lindblandro/poly/documentation/img/block-diagram-map.pdf

Loops

Initialization

Arduino

Sequencer

Handler

Acquisition

Concentration

Temperature
