lindblandro/poly/documentation/img/pipelining2.pdf

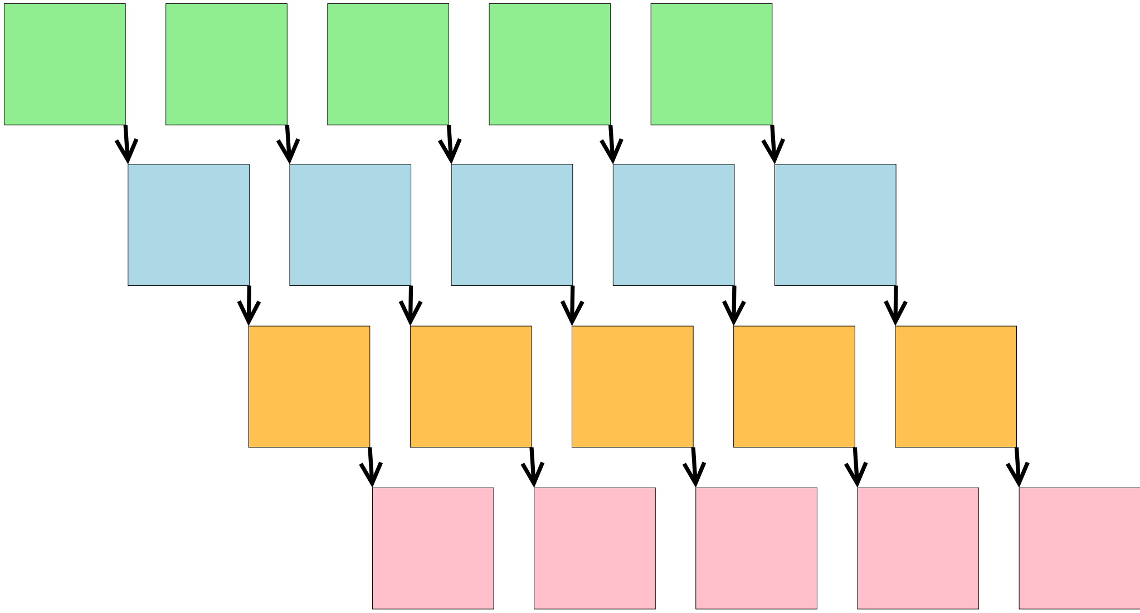
[picture p8: figure]

Time

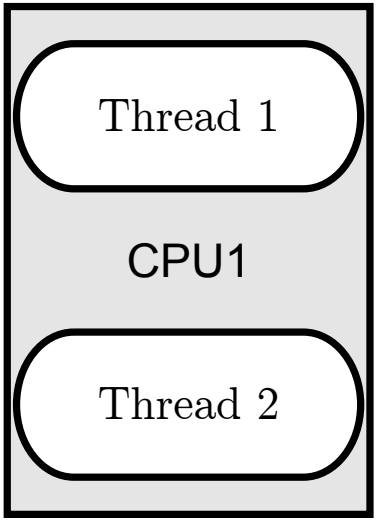
[picture p9: figure]
Thread 2; Thread 1; CPU1
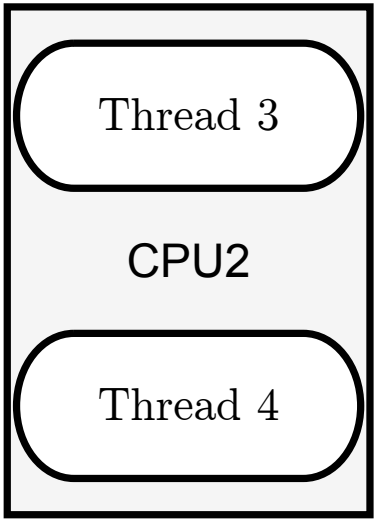
[picture p10: figure]
Thread 3; Thread 4; CPU2
