lindblandro/poly/documentation/AC-coupled-non-inverting.pdf

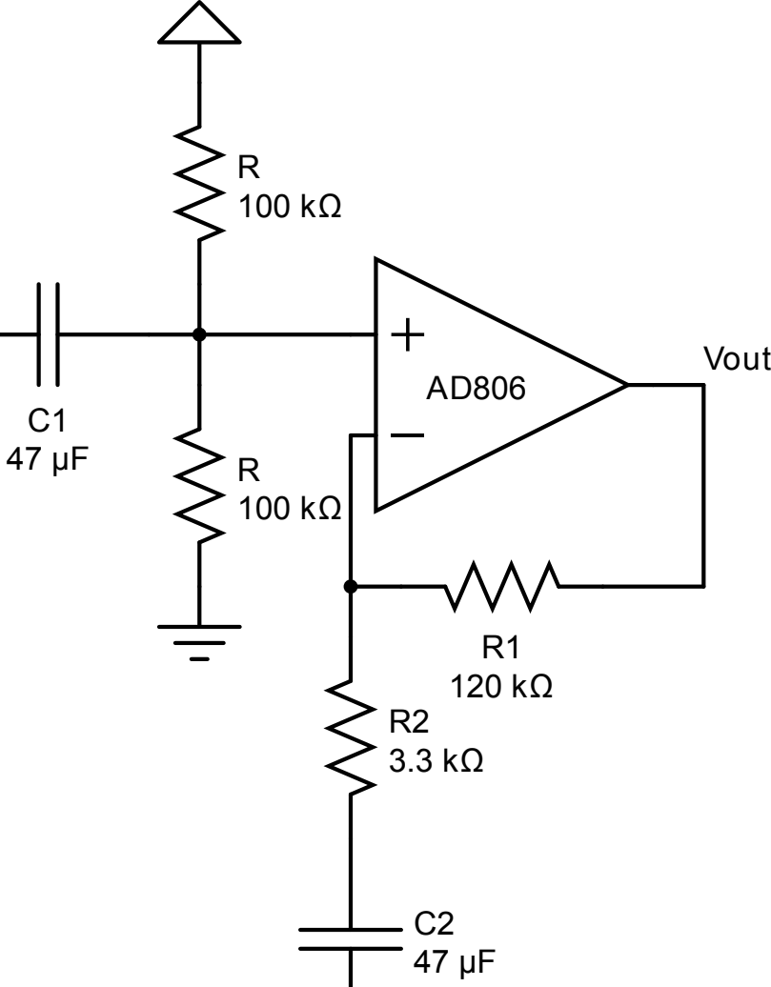
[picture p11: figure]
Vout

Vin
