lindblandro/poly/documentation/level_converter.pdf

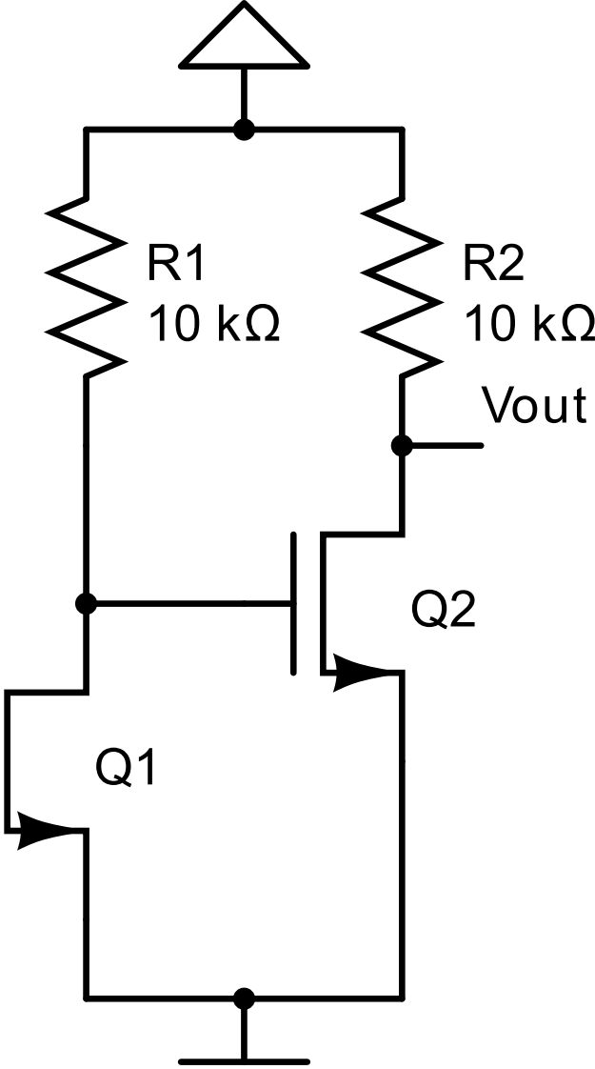
[picture p12: figure]
R2 10 kΩ Vout

Vin
