lindblandro/poly/documentation/img/dataflow.pdf

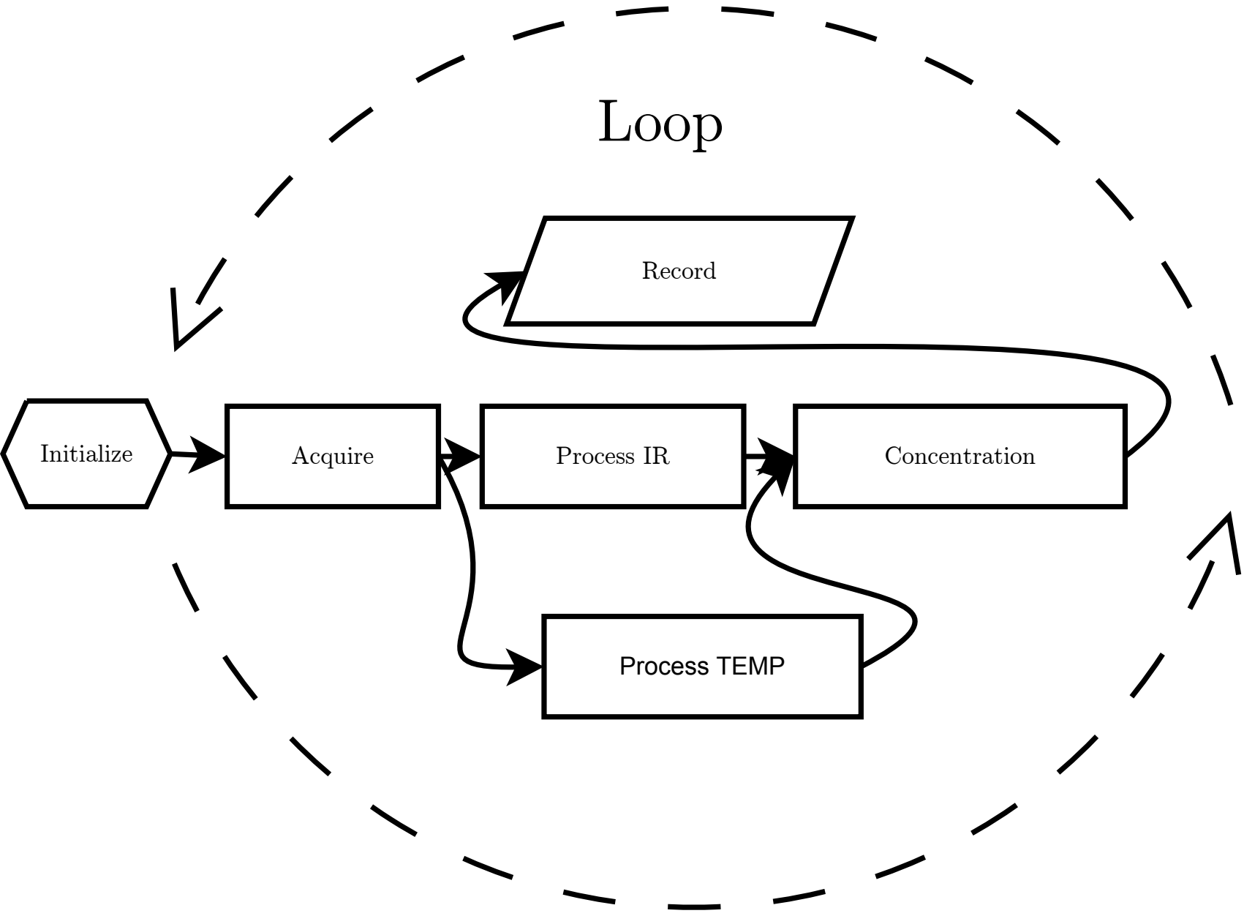
[picture p13: figure]
Acquire; Process TEMP; Initialize; Process IR; Concentration; Record; Loop
