lindblandro/poly/documentation/img/front-panel-upper.pdf

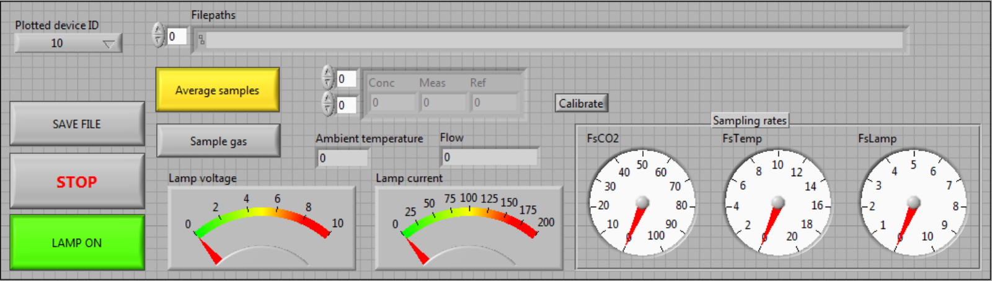
[picture p14: page 1]
