lindblandro/poly/documentation/img/pipelining.pdf

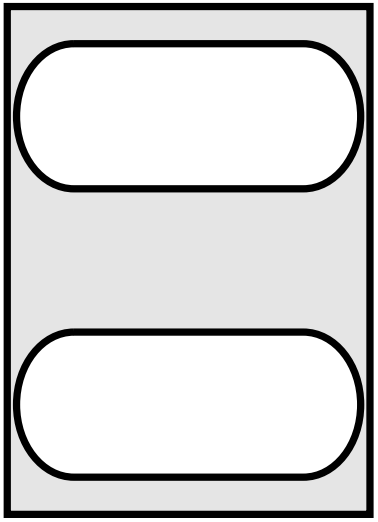
[picture p15: figure]
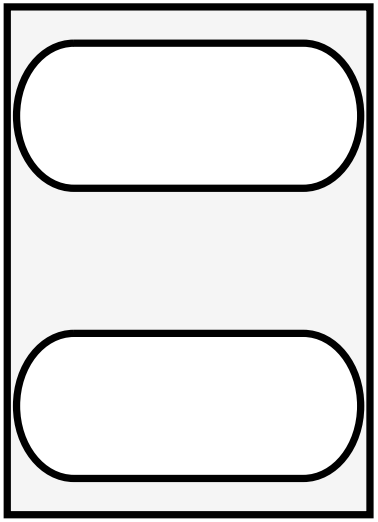
[picture p16: figure]
