lindblandro/poly/documentation/conductance_measurement.pdf

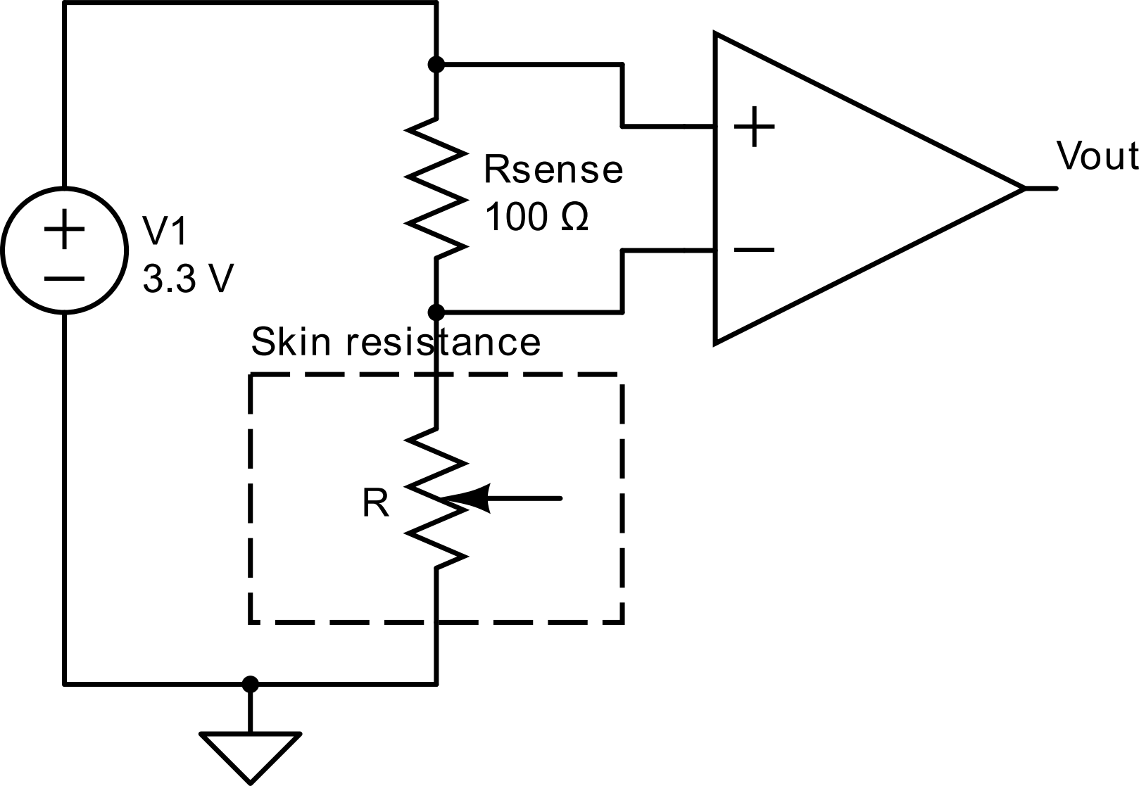
[picture p17: figure]
Rsense 100 Ω; Skin resistance; Vout
