lindblandro/poly/documentation/3v-regulator.pdf

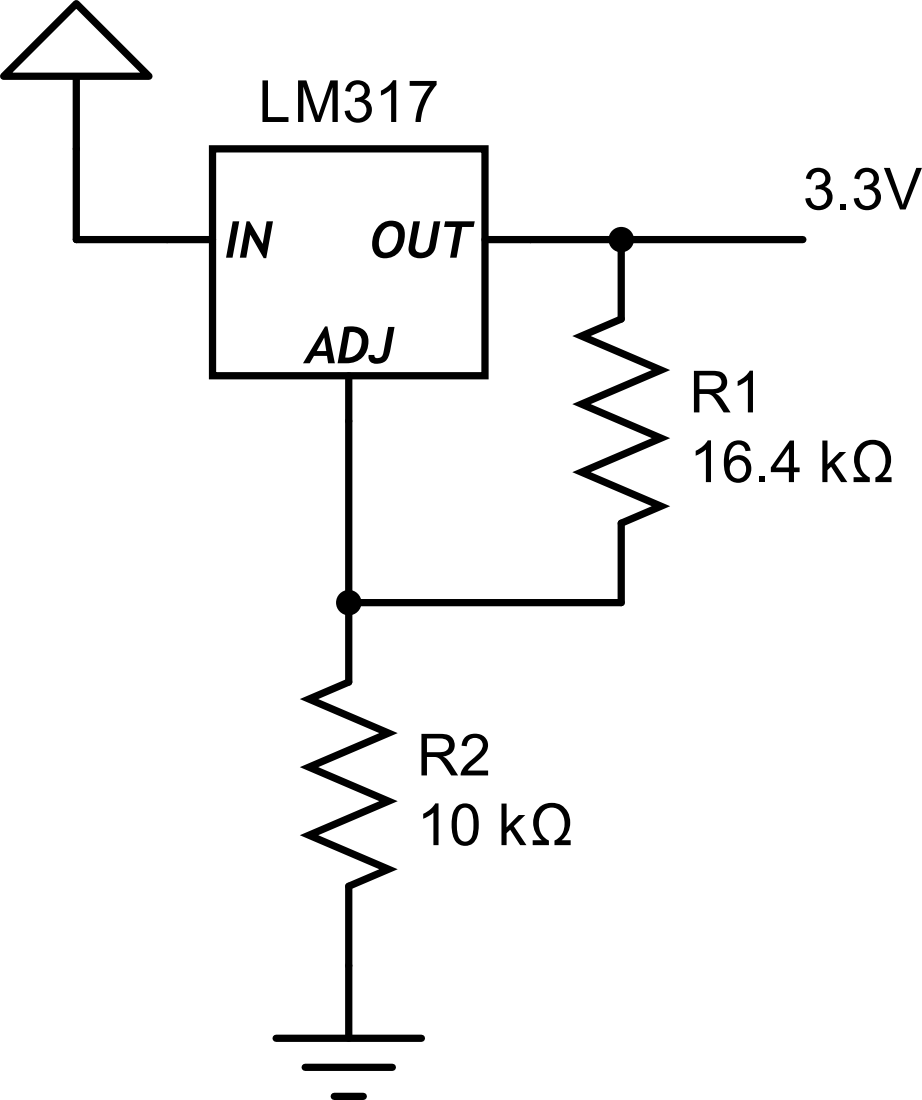
[picture p18: page 1]
