lindblandro/poly/documentation/ina-ac-coupled.pdf

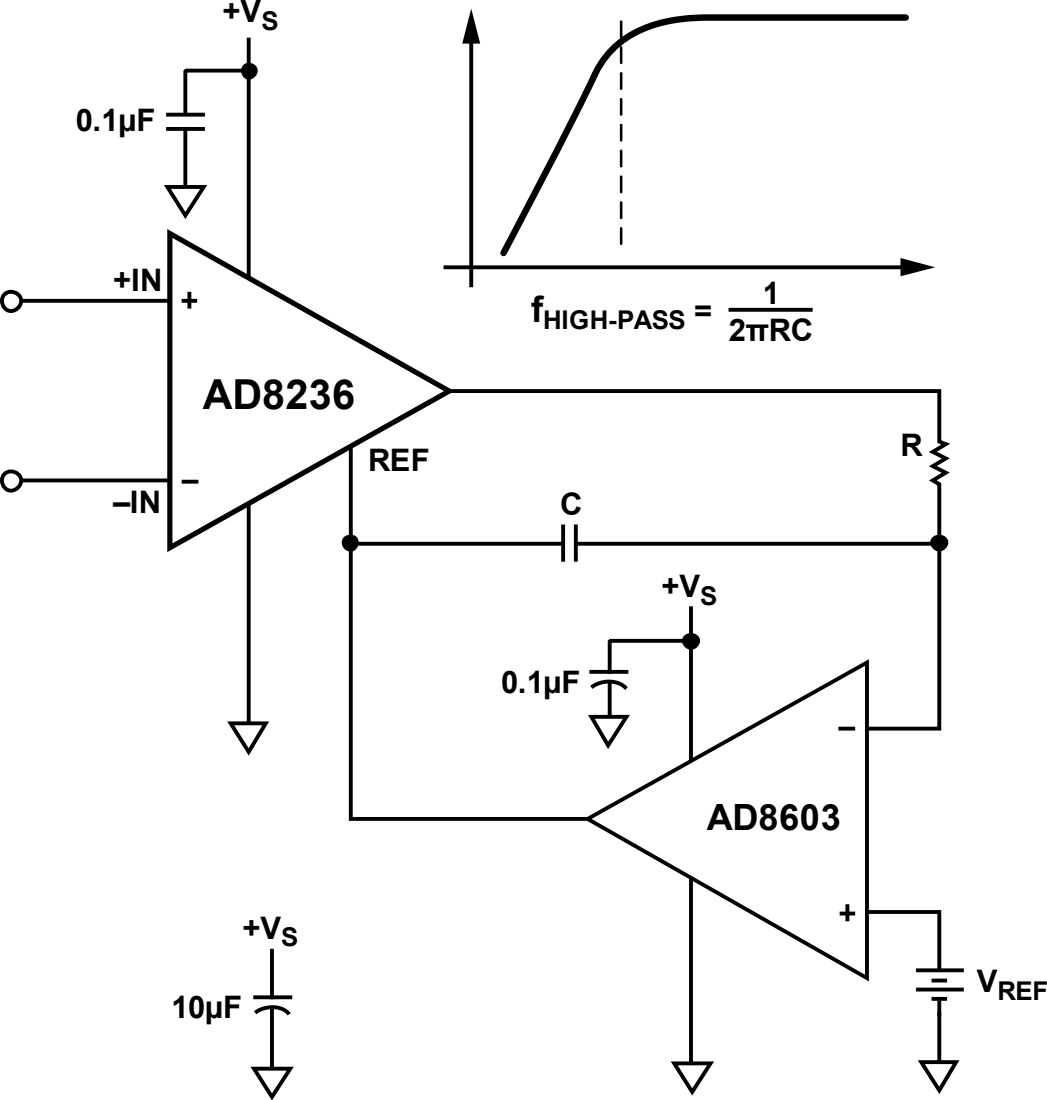
[picture p19: page 1]
REF; VREF; 1 2πRC fHIGH-PASS =
