lindblandro/poly/eagle-files/Polygraph/edr.brd

## EAGLE design eagle-files/Polygraph/edr.brd (2012-06-20)

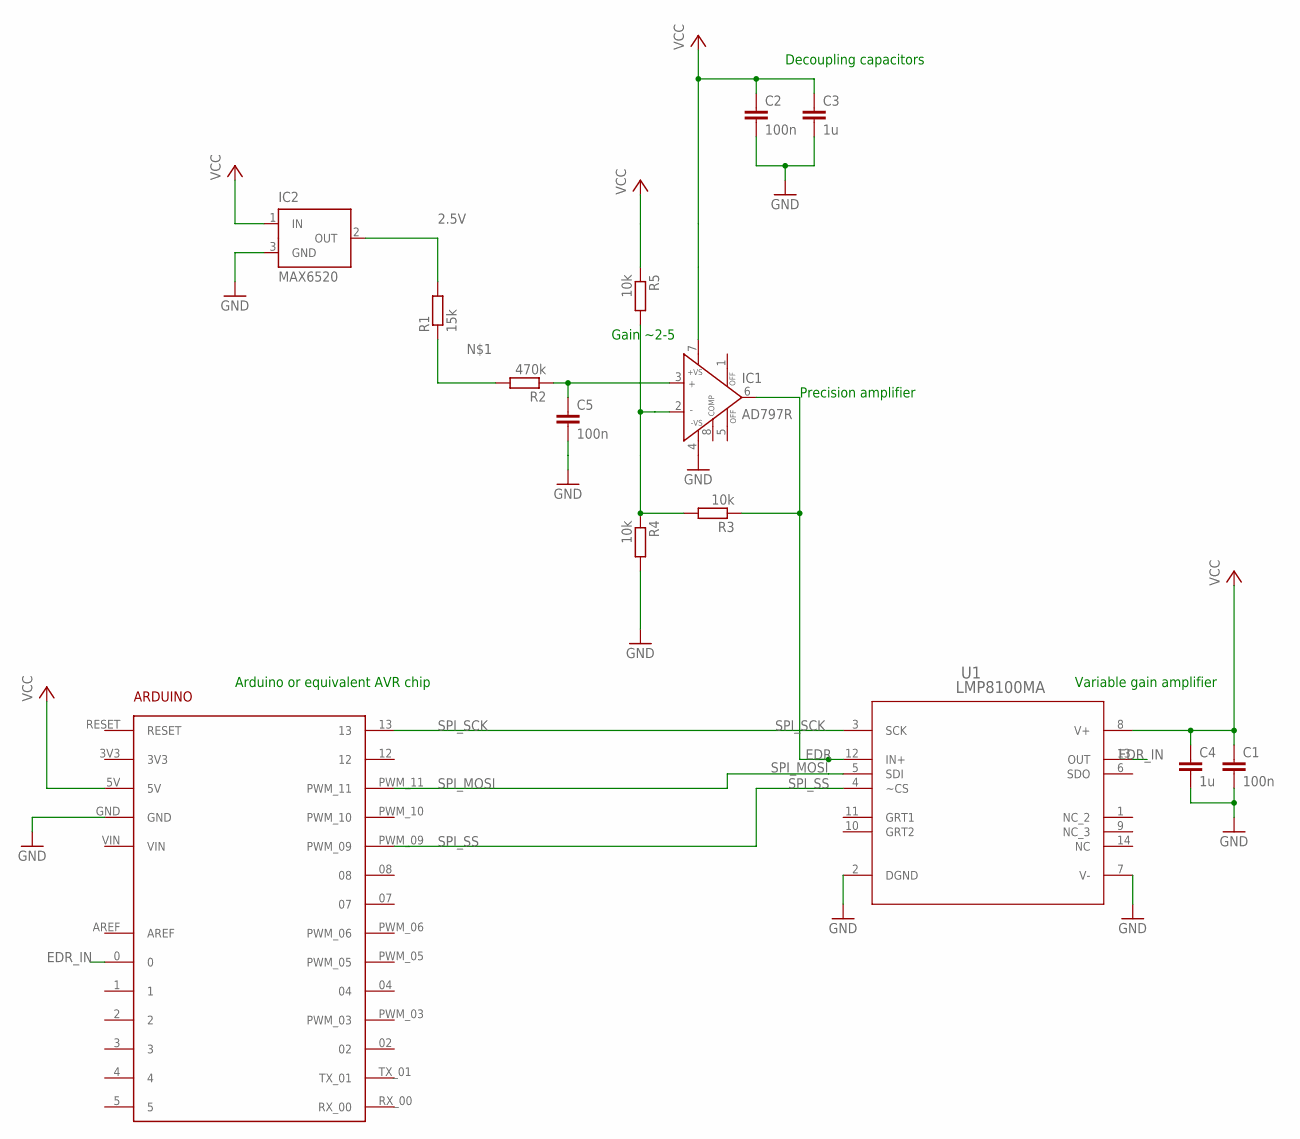
[picture p23: schematic edr.sch]

Parts:
ARDUINO1: ARDUINO2
C1, C2, C5: 100n; C0603
C3, C4: 1u; C0805
IC1: AD797R; SO8
IC2: MAX6520; SOT23
R1: 15k; R0603
R2: 470k; R0603
R3, R4, R5: 10k; R0603
U1: LMP8100MA; M14A

Connections:
2.5V: IC2.2 (OUT), R1.2
EDR: IC1.6 (OUT), R3.1, U1.12 (IN+)
EDR_IN: ARDUINO1.0, U1.13 (OUT)
GND: ARDUINO1.GND, C1.2, C2.2, C3.2, C4.2, C5.2, IC1.4 (-VS), IC2.3 (GND), R4.2, U1.2 (DGND), U1.7 (V-)
unnamed: R1.1, R2.2
unnamed: C5.1, IC1.3 (IN+), R2.1
unnamed: IC1.2 (IN-), R3.2, R4.1, R5.2
SPI_MOSI: ARDUINO1.PWM_11, U1.5 (SDI)
SPI_SCK: ARDUINO1.13, U1.3 (SCK)
SPI_SS: ARDUINO1.PWM_09, U1.4 (~CS)
VCC: ARDUINO1.5V, C1.1, C2.1, C3.1, C4.1, IC1.7 (+VS), IC2.1 (IN), R5.1, U1.8 (V+)

Notes on the sheet:
Decoupling capacitors
Precision amplifier
Variable gain amplifier
Arduino or equivalent AVR chip
Gain ~2-5

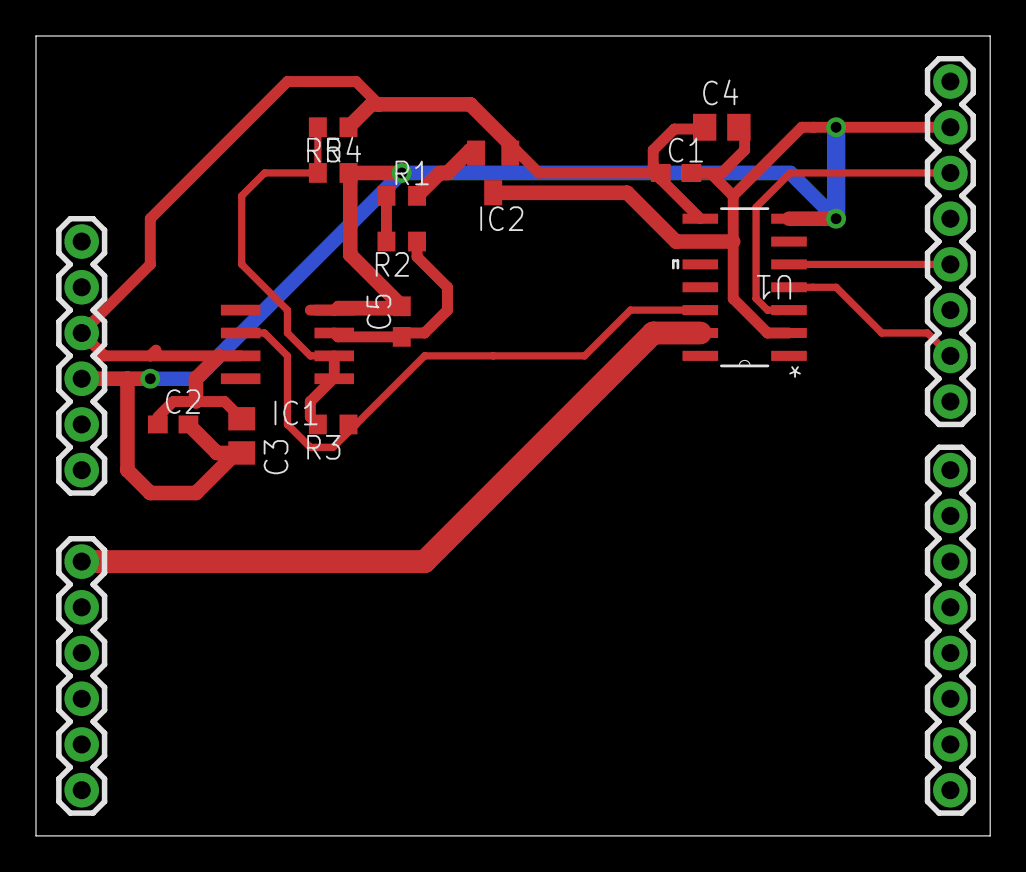
[picture p24: board edr.brd from above]

Board: 2 copper layers, 53.0 x 44.4 mm, 14 parts (0 on the bottom side), 11 nets.
