lindblandro/poly/(commit log)

2012-06-18 First version of the Arduino firmware.
2012-06-20 Eagle schematic and board layout. Lacks connector for the EDR and other sensors.
    [edr.brd, edr.sch]
2013-04-30 Added docs and datasheets and some labview code.
    [Arduino-Mini-v5.brd, Arduino-Mini-v5.sch]
